ThatAquarel/differential_probe/hw/differential_probe/differential_probe.kicad_pcb

## KiCad design hw/differential_probe/differential_probe.kicad_pcb (2026-02-07)

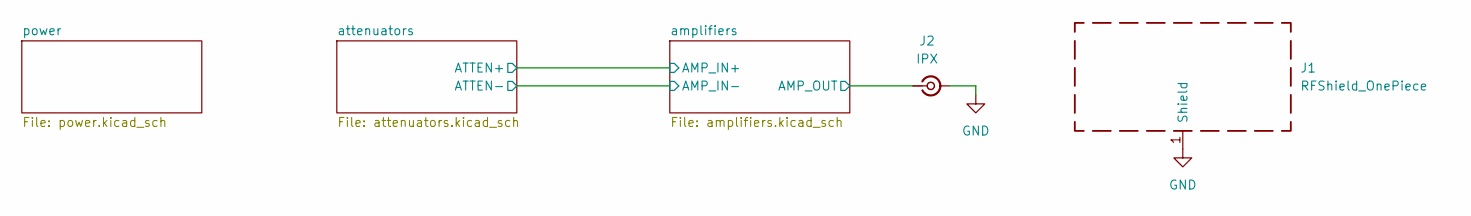
[picture p1: schematic differential_probe.kicad_sch]

Parts:
J1: RFShield_OnePiece
J2: IPX; BWIPX-1-001E; MFR PART # C496552

Connections:
/amplifiers/AMP_OUT: J2.1 (In); also elsewhere on the board
GND: J1.1, J2.2 (Ext); also elsewhere on the board

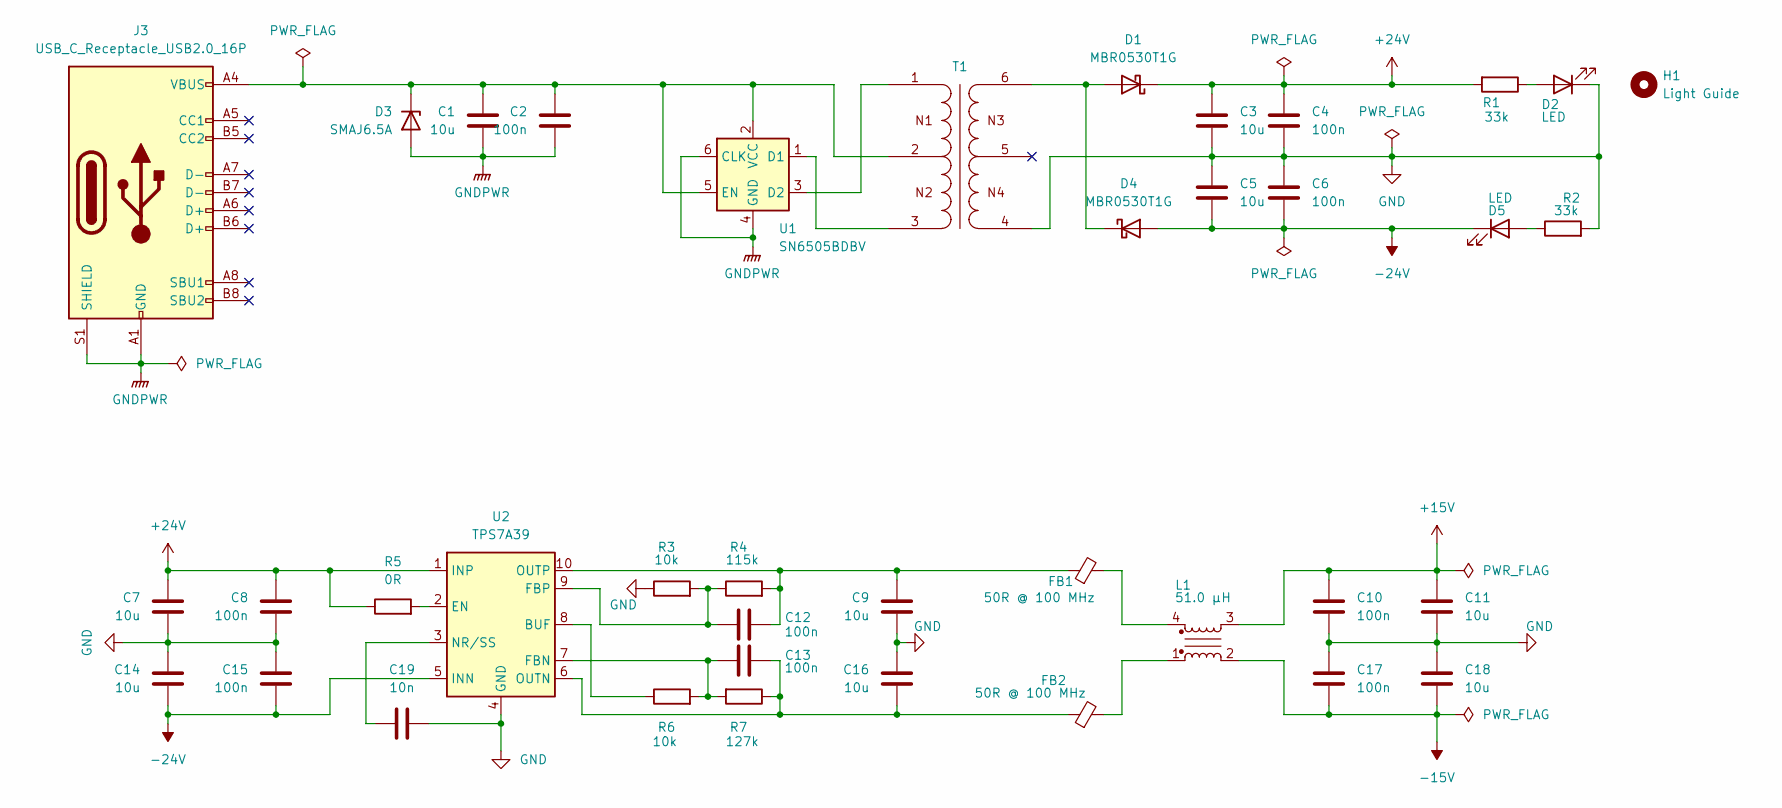
[picture p2: schematic power.kicad_sch]

Parts:
C1, C3, C5, C7, C9, C11, C14, C16, C18: 10u; C_1206_3216Metric; LCSC C13585
C2, C4, C6, C8, C10, C12, C13, C15, C17: 100n; C_0402_1005Metric; LCSC C307331
C19: 10n; C_0805_2012Metric; LCSC C1710
D1, D4: MBR0530T1G; D_SOD-123; MFR PART # MBR0530T1G
D2, D5: LED; LED_0805_2012Metric; LCSC C34499
D3: SMAJ6.5A; D_SMA_Handsoldering; MFR PART # SMAJ6.5A
FB1, FB2: 50R @ 100 MHz; L_0402_1005Metric_Pad0.77x0.64mm_HandSolder; MFR PART # LQW15AN47NJ00D
H1: Light Guide; SLP3-150-100-F
J3: USB_C_Receptacle_USB2.0_16P; USB_C_Receptacle_G-Switch_GT-USB-7043; LCSC C2762982
L1: 1812_744235510; L_Wurth_WE-CNSW-1812; Part Number 744235510
R1, R2: 33k; R_0805_2012Metric; LCSC C17633
R3, R6: 10k; R_0402_1005Metric; LCSC C25744
R4: 115k; R_0402_1005Metric_Pad0.72x0.64mm_HandSolder; MFR PART # ERJ-2RKF1153X
R5: 0R; R_0402_1005Metric_Pad0.72x0.64mm_HandSolder; LCSC C17168
R7: 127k; R_0402_1005Metric_Pad0.72x0.64mm_HandSolder; MFR PART # ERJ-2RKF1273X
T1: 1006_760390014; T_Wurth_WE-PPTI-1006; Part Number 760390014
U1: SN6505BDBV; SOT-23-6; LCSC C74518
U2: TPS7A39; Texas_S-PVSON-N10_ThermalVias; LCSC C2685819

Connections:
+15V: C10.1, C11.1, L1.3; also elsewhere on the board
+24V: C3.1, C4.1, C7.1, C8.1, D1.1 (K), R1.2, R5.1, U2.1 (INP)
-15V: C17.2, C18.2, L1.2; also elsewhere on the board
-24V: C5.2, C6.2, C14.2, C15.2, D4.2 (A), D5.1 (K), U2.5 (INN)
GND: C3.2, C4.2, C5.1, C6.1, C7.2, C8.2, C9.2, C10.2, C11.2, C14.1, C15.1, C16.1, C17.1, C18.1, C19.2, D2.1 (K), R2.2, R3.1, T1.4, U2.4 (GND), U2.11 (GND); also elsewhere on the board
GNDPWR: C1.2, C2.2, D3.2 (A), J3.A1 (GND), J3.A12 (GND), J3.B1 (GND), J3.B12 (GND), J3.S1 (SHIELD), U1.4 (GND), U1.6 (CLK)
unnamed: D1.2 (A), D4.1 (K), T1.6
unnamed: D2.2 (A), R1.1
unnamed: C1.1, C2.1, D3.1 (K), J3.A4 (VBUS), J3.A9 (VBUS), J3.B4 (VBUS), J3.B9 (VBUS), T1.2, U1.2 (VCC), U1.5 (EN)
unnamed: D5.2 (A), R2.1
unnamed: FB1.2, L1.4
unnamed: FB2.2, L1.1
unnamed: T1.3, U1.1 (D1)
unnamed: T1.1, U1.3 (D2)
unnamed: R6.1, U2.8 (BUF)
unnamed: R5.2, U2.2 (EN)
unnamed: C13.2, R6.2, R7.2, U2.7 (FBN)
unnamed: C12.2, R3.2, R4.1, U2.9 (FBP)
unnamed: C19.1, U2.3 (NR/SS)
unnamed: C13.1, C16.2, FB2.1, R7.1, U2.6 (OUTN)
unnamed: C9.1, C12.1, FB1.1, R4.2, U2.10 (OUTP)

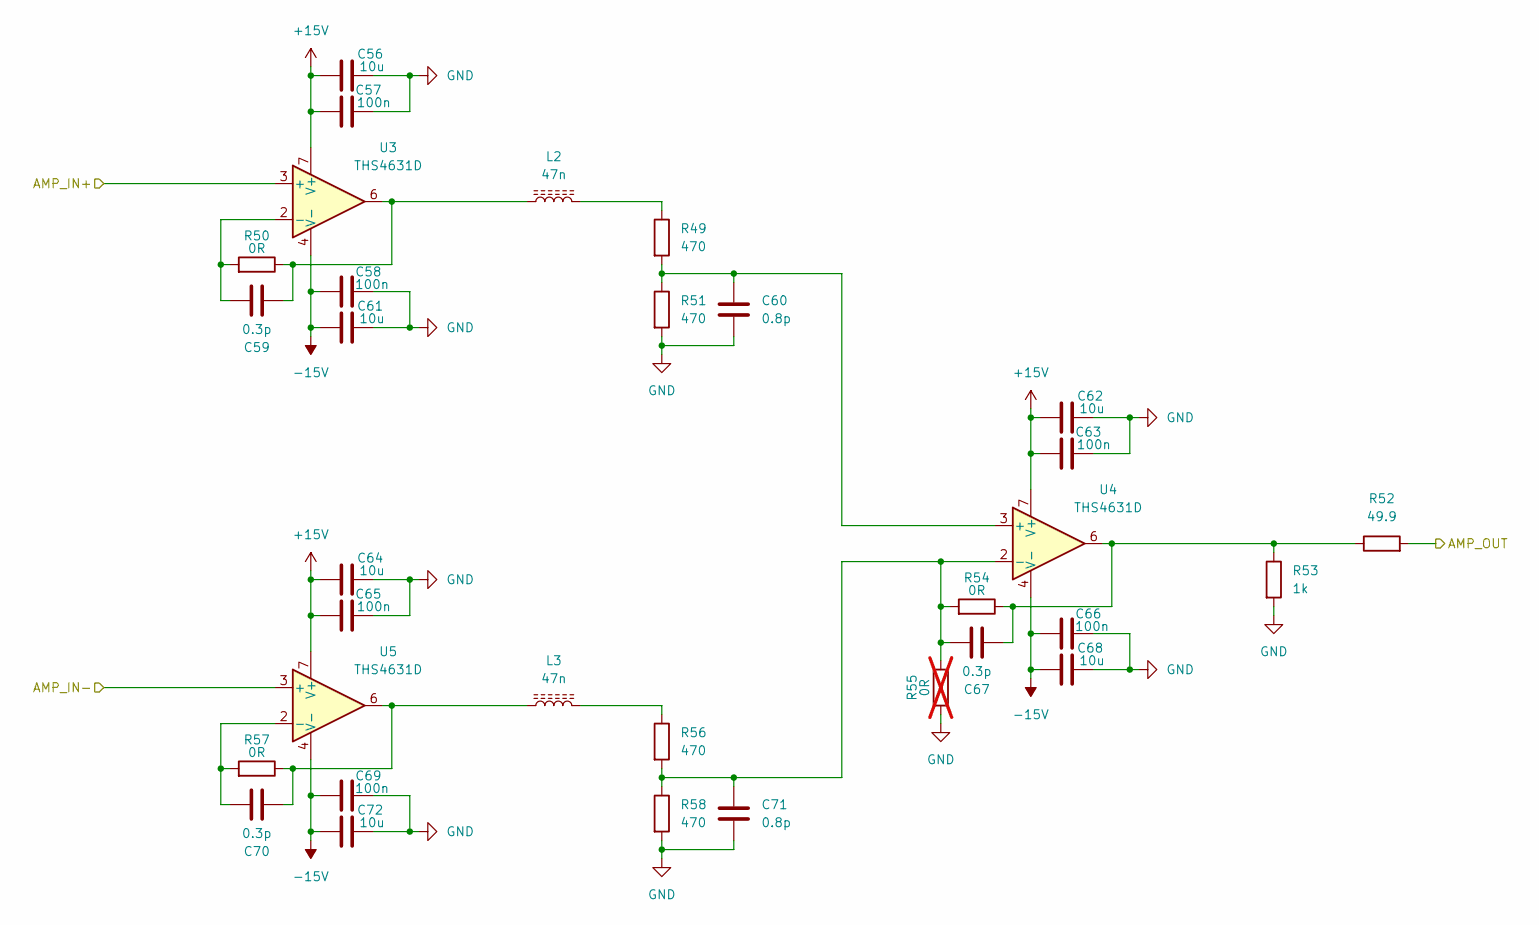
[picture p3: schematic amplifiers.kicad_sch]

Parts:
C56, C61, C62, C64, C68, C72: 10u; C_1206_3216Metric; LCSC C13585
C57, C58, C63, C65, C66, C69: 100n; C_0402_1005Metric; LCSC C307331
C59, C67, C70: 0.3p; C_0402_1005Metric_Pad0.74x0.62mm_HandSolder; MFR PART # GJM1555C1HR30WB01D
C60, C71: 0.8p; C_0402_1005Metric_Pad0.74x0.62mm_HandSolder; MFR PART # GJM1555C1HR80WB01D
L2, L3: 47n; L_0402_1005Metric_Pad0.77x0.64mm_HandSolder; MFR PART # LQW15AN47NJ00D
R49, R51, R56, R58: 470; R_0805_2012Metric; LCSC C17710
R50, R54, R57: 0R; R_0402_1005Metric_Pad0.72x0.64mm_HandSolder; LCSC C17168
R52: 49.9; R_0805_2012Metric; LCSC C17720
R53: 1k; R_1206_3216Metric; LCSC C4410
R55: 0R; R_0402_1005Metric_Pad0.72x0.64mm_HandSolder; not fitted
U3, U4, U5: THS4631D; SOIC-8_3.9x4.9mm_P1.27mm; MFR PART # THS4631DR

Connections:
+15V: C56.1, C57.2, C62.1, C63.2, C64.1, C65.2, U3.7 (V+), U4.7 (V+), U5.7 (V+); also elsewhere on the board
-15V: C58.1, C61.1, C66.1, C68.1, C69.1, C72.1, U3.4 (V-), U4.4 (V-), U5.4 (V-); also elsewhere on the board
/amplifiers/AMP_IN+: U3.3 (+); also elsewhere on the board
/amplifiers/AMP_IN-: U5.3 (+); also elsewhere on the board
/amplifiers/AMP_OUT: R52.2; also elsewhere on the board
GND: C56.2, C57.1, C58.2, C60.2, C61.2, C62.2, C63.1, C64.2, C65.1, C66.2, C68.2, C69.2, C71.2, C72.2, R51.2, R53.2, R55.2, R58.2; also elsewhere on the board
unnamed: C59.2, L2.1, R50.1, U3.6
unnamed: C67.2, R52.1, R53.1, R54.1, U4.6
unnamed: C70.2, L3.1, R57.1, U5.6
unnamed: L2.2, R49.1
unnamed: L3.2, R56.1
unnamed: C59.1, R50.2, U3.2 (-)
unnamed: C60.1, R49.2, R51.1, U4.3 (+)
unnamed: C67.1, C71.1, R54.2, R55.1, R56.2, R58.1, U4.2 (-)
unnamed: C70.1, R57.2, U5.2 (-)

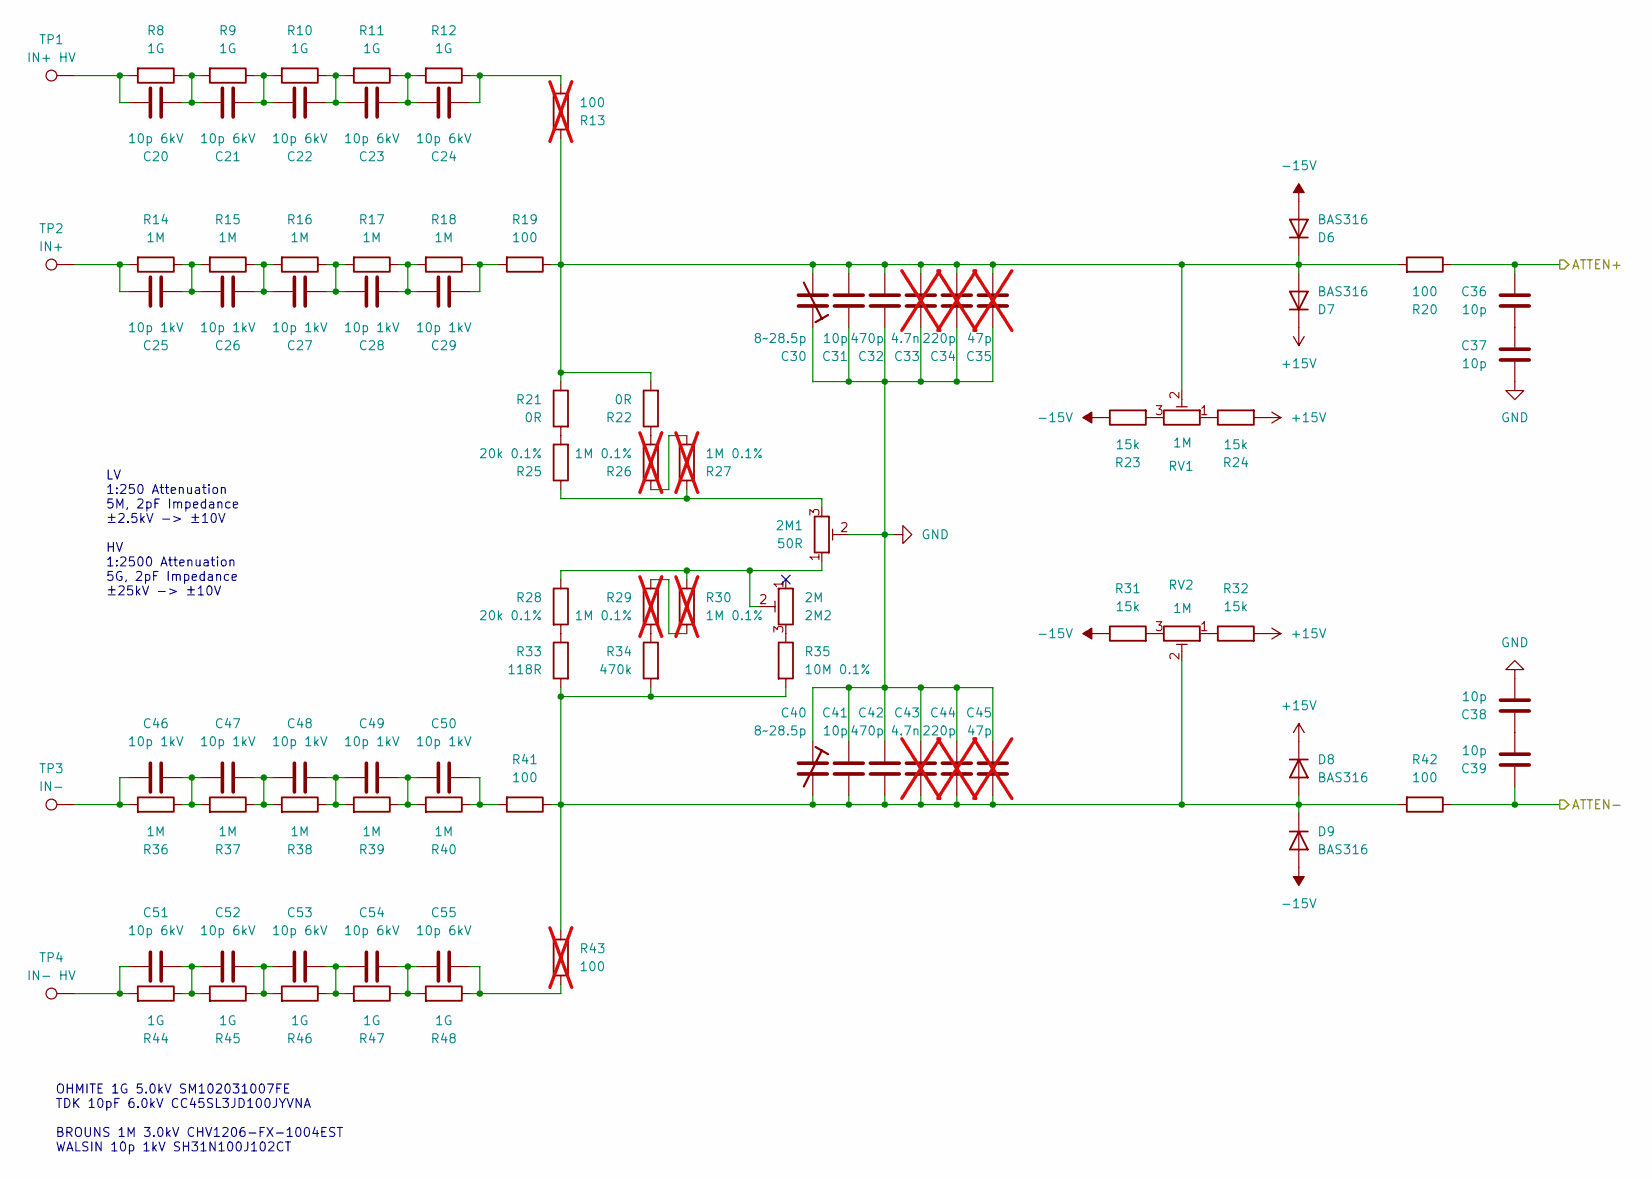
[picture p4: schematic attenuators.kicad_sch]

Parts:
2M1: 50R; Potentiometer_Bourns_3296W_Vertical; MFR PART # 3296W-1-500LF
2M2: 2M; Potentiometer_Bourns_3296W_Vertical; MFR PART # 3296W-1-205LF
C20, C21, C22, C23, C24, C51, C52, C53, C54, C55: 10p 6kV; C_Rect_L9.0mm_W6.4mm_P7.50mm_MKT; MFR PART # CC45SL3JD100JYVNA
C25, C26, C27, C28, C29, C46, C47, C48, C49, C50: 10p 1kV; C_1206_3216Metric_Pad1.33x1.80mm_HandSolder; MFR PART # SH31N100J102CT
C30, C40: 8~28.5p; C_Trimmer_Voltronics_JZ; LCSC C22468123
C31, C36, C37, C38, C39, C41: 10p; C_0805_2012Metric; LCSC C1743
C32, C42: 470p; C_0805_2012Metric; LCSC C1743
C33, C43: 4.7n; C_0805_2012Metric_Pad1.18x1.45mm_HandSolder; MFR PART # C0805C472J2GEC7210; not fitted
C34, C44: 220p; C_0805_2012Metric_Pad1.18x1.45mm_HandSolder; MFR PART # CC0805JRNPO9BN221; not fitted
C35, C45: 47p; C_0805_2012Metric_Pad1.18x1.45mm_HandSolder; MFR PART # C0805X470J5GACTU; not fitted
D6, D7, D8, D9: BAS316; D_SOD-323; MFR PART # BAS316
R8, R9, R10, R11, R12, R44, R45, R46, R47, R48: 1G; R_Axial_DIN0207_L6.3mm_D2.5mm_P10.16mm_Horizontal; MFR PART # SM102031007FE
R13, R43: 100; R_0805_2012Metric; not fitted
R14, R15, R16, R17, R18, R36, R37, R38, R39, R40: 1M; R_1206_3216Metric_Pad1.30x1.75mm_HandSolder; MFR PART # CHV1206-FX-1004EST
R19, R20, R41, R42: 100; R_1206_3216Metric_Pad1.30x1.75mm_HandSolder; LCSC C17901
R21, R22: 0R; R_1206_3216Metric_Pad1.30x1.75mm_HandSolder; LCSC C17888
R23, R24, R31, R32: 15k; R_0603_1608Metric; LCSC C22809
R25, R28: 20k 0.1%; R_1206_3216Metric_Pad1.30x1.75mm_HandSolder; MFR PART # RNCF1206BTE20K0
R26, R27, R29, R30: 1M 0.1%; R_1206_3216Metric_Pad1.30x1.75mm_HandSolder; MFR PART # RNCS1206BKE1M00; not fitted
R33: 118R; R_1206_3216Metric_Pad1.30x1.75mm_HandSolder; MFR PART # RMCF1206FT118R
R34: 470k; R_0805_2012Metric; MFR PART # C17709
R35: 10M 0.1%; R_1206_3216Metric_Pad1.30x1.75mm_HandSolder; MFR PART # MCA1206MD1005BP100
RV1, RV2: 1M; Potentiometer_Bourns_3296Y_Vertical; MFR PART # 3296Y-1-105LF
TP1: IN+ HV; TestPoint_Loop_D2.50mm_Drill1.85mm
TP2: IN+; TestPoint_Loop_D2.50mm_Drill1.85mm
TP3: IN-; TestPoint_Loop_D2.50mm_Drill1.85mm
TP4: IN- HV; TestPoint_Loop_D2.50mm_Drill1.85mm

Connections:
+15V: D7.1 (K), D8.1 (K), R24.2, R32.2; also elsewhere on the board
-15V: D6.2 (A), D9.2 (A), R23.1, R31.1; also elsewhere on the board
/amplifiers/AMP_IN+: C36.1, R20.1; also elsewhere on the board
/amplifiers/AMP_IN-: C39.1, R42.1; also elsewhere on the board
GND: 2M1.2, C30.1, C31.1, C32.1, C33.1, C34.1, C35.1, C37.2, C38.2, C40.1, C41.1, C42.1, C43.1, C44.1, C45.1; also elsewhere on the board
unnamed: 2M1.1, 2M2.2, R28.1, R30.1
unnamed: 2M1.3, R25.1, R27.1
unnamed: 2M2.3, R35.1
unnamed: C20.1, R8.2, TP1.1
unnamed: C20.2, C21.1, R8.1, R9.2
unnamed: C21.2, C22.1, R9.1, R10.2
unnamed: C22.2, C23.1, R10.1, R11.2
unnamed: C23.2, C24.1, R11.1, R12.2
unnamed: C24.2, R12.1, R13.1
unnamed: C25.1, R14.2, TP2.1
unnamed: C25.2, C26.1, R14.1, R15.2
unnamed: C26.2, C27.1, R15.1, R16.2
unnamed: C27.2, C28.1, R16.1, R17.2
unnamed: C28.2, C29.1, R17.1, R18.2
unnamed: C29.2, R18.1, R19.2
unnamed: C36.2, C37.1
unnamed: C38.1, C39.2
unnamed: C46.1, R36.2, TP3.1
unnamed: C46.2, C47.1, R36.1, R37.2
unnamed: C47.2, C48.1, R37.1, R38.2
unnamed: C48.2, C49.1, R38.1, R39.2
unnamed: C49.2, C50.1, R39.1, R40.2
unnamed: C50.2, R40.1, R41.2
unnamed: C51.1, R44.2, TP4.1
unnamed: C51.2, C52.1, R44.1, R45.2
unnamed: C52.2, C53.1, R45.1, R46.2
unnamed: C53.2, C54.1, R46.1, R47.2
unnamed: C54.2, C55.1, R47.1, R48.2
unnamed: C55.2, R43.1, R48.1
unnamed: C30.2, C31.2, C32.2, C33.2, C34.2, C35.2, D6.1 (K), D7.2 (A), R13.2, R19.1, R20.2, R21.1, R22.2, RV1.2
unnamed: C40.2, C41.2, C42.2, C43.2, C44.2, C45.2, D8.2 (A), D9.1 (K), R33.2, R34.2, R35.2, R41.1, R42.2, R43.2, RV2.2
unnamed: R21.2, R25.2
unnamed: R22.1, R26.2
unnamed: R23.2, RV1.3
unnamed: R24.1, RV1.1
unnamed: R26.1, R27.2
unnamed: R28.2, R33.1
unnamed: R29.1, R30.2
unnamed: R29.2, R34.1
unnamed: R31.2, RV2.3
unnamed: R32.1, RV2.1

Notes on the sheet:
OHMITE 1G 5.0kV SM102031007FE TDK 10pF 6.0kV CC45SL3JD100JYVNA BROUNS 1M 3.0kV CHV1206-FX-1004EST WALSIN 10p 1kV SH31N100J102CT
LV 1:250 Attenuation 5M, 2pF Impedance ±2.5kV -> ±10V HV 1:2500 Attenuation 5G, 2pF Impedance ±25kV -> ±10V

Board: 2 copper layers, 161 parts (0 on the bottom side), 74 nets, no tracks yet.
