ThatAquarel/differential_probe/(commit log)

2026-02-07 initial schematic
    [amplifiers.kicad_sch, attenuators.kicad_sch, differential_probe.kicad_pcb, differential_probe.kicad_sch, power.kicad_sch]
2026-02-07 initial routing
    [amplifiers.kicad_sch, attenuators.kicad_sch, differential_probe.kicad_pcb, differential_probe.kicad_sch, power.kicad_sch]
